full-of-beans/cenmate-fan-controller/hardware/fan-controller.step

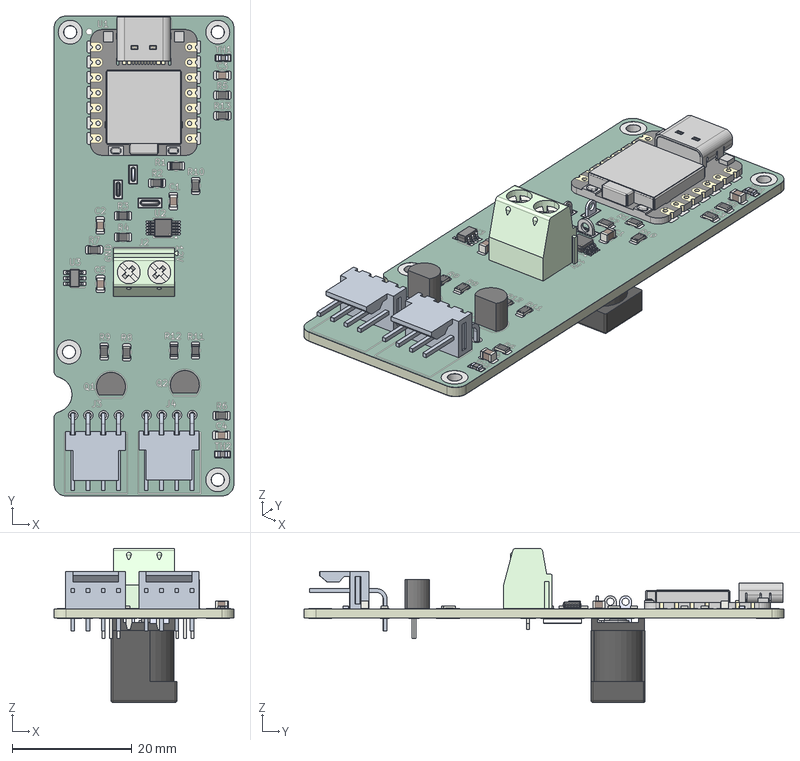
[picture p1: CAD file, 2026-11-06]
hardware/fan-controller.step
30.0 x 80.0 x 25.7 mm
NCU18WB473D60RB x 2
R_0805_2012Metric x 13
C_0805_2012Metric x 5
BODY-SOT
LEAD-SOT x 6
TO-92_Inline_Narrow x 2
XIAO RP2350 v1
BC-508X10-2_GN
TSSOP-10_3x3mm_P0.5mm
CRF2512-FV-R002ELF
fan-controller_copper
fan-controller_pad
fan-controller_via
fan-controller_silkscreen x 2
fan-controller_soldermask x 2
fan-controller_PCB
