full-of-beans/cenmate-fan-controller/hardware/fan-controller.kicad_pcb

## KiCad design hardware/fan-controller.kicad_pcb (2026-11-14)

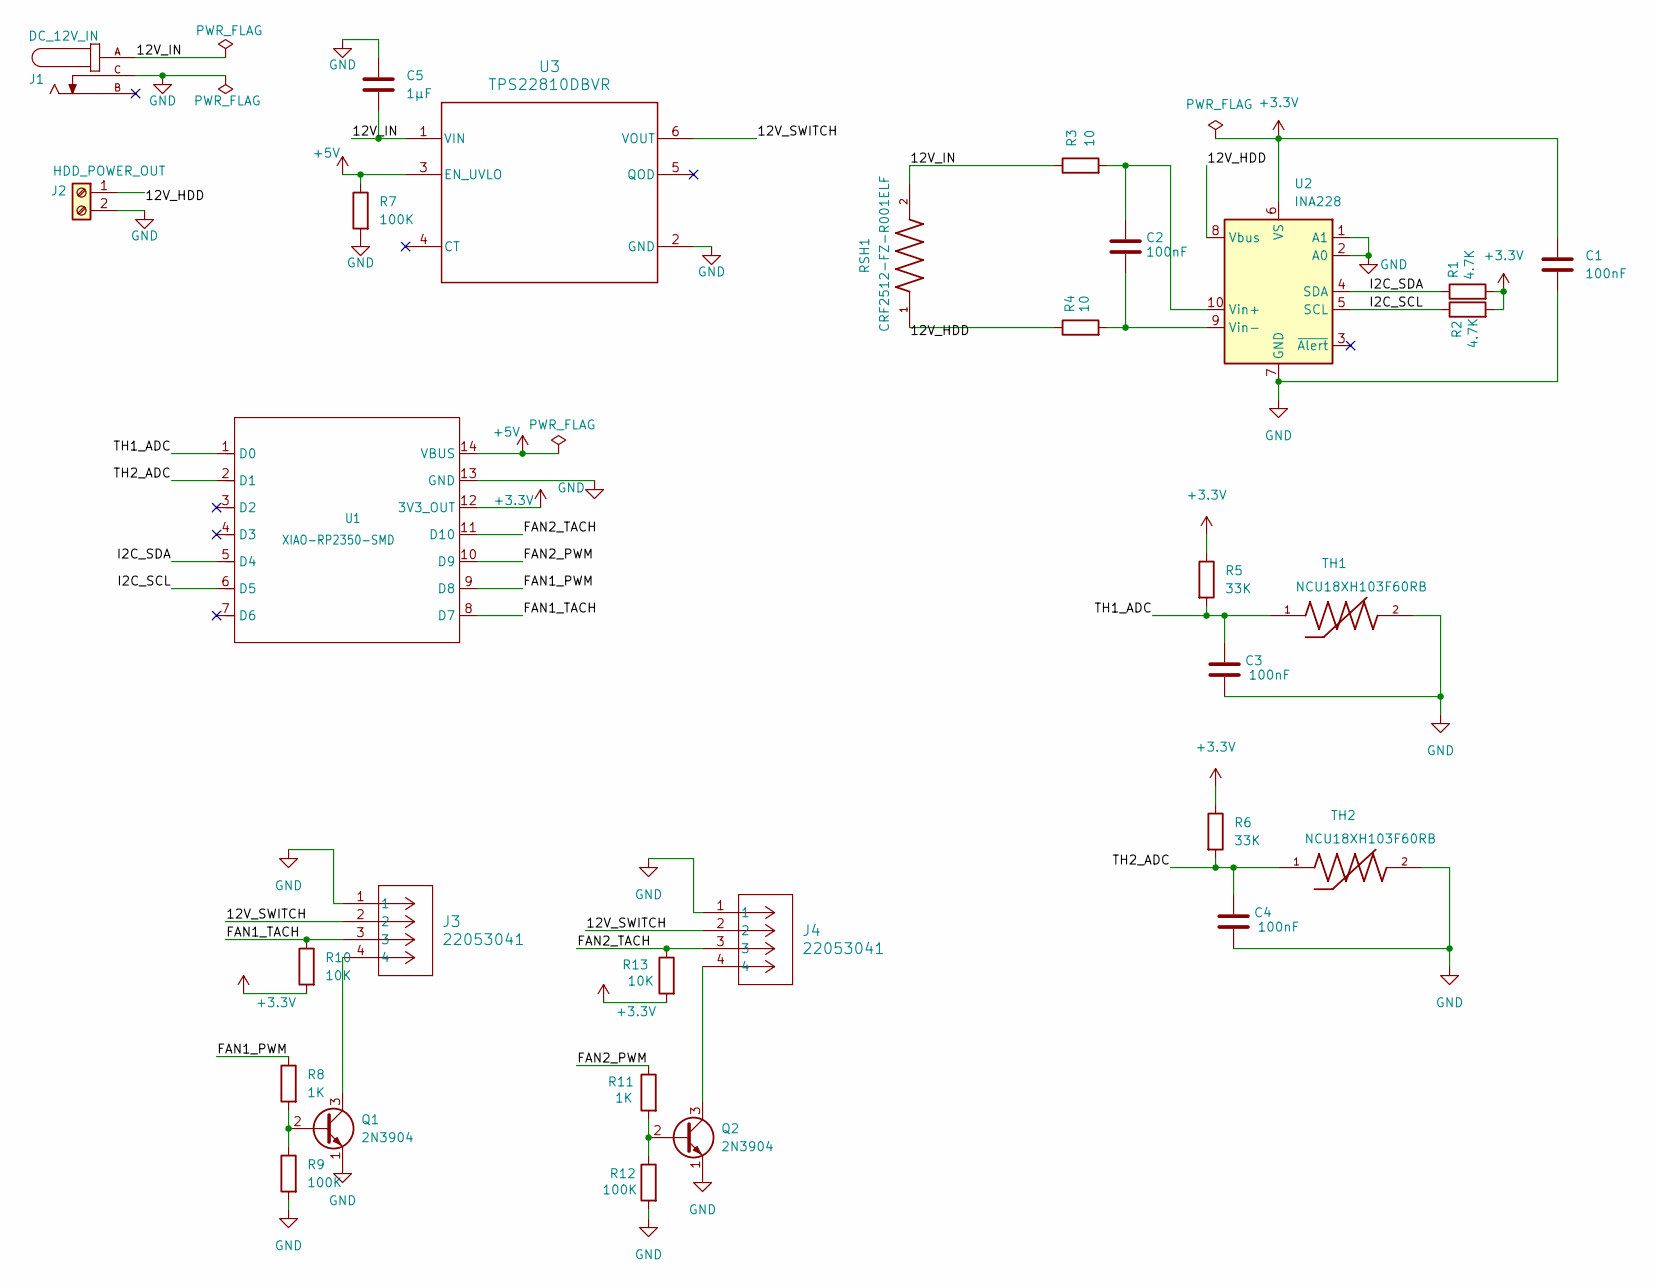
[picture p2: schematic fan-controller.kicad_sch]

Parts:
C1, C2, C3, C4: 100nF; C_0805_2012Metric; MPN CL21B104KACNFNC; DigiKey_PN 1276-2442-1-ND
C5: 1µF; C_0805_2012Metric; MPN GRM219R71E105KA88D; DigiKey_PN 490-5899-1-ND
J1: DC_12V_IN; TENSILITY_54-00286; MPN 54-00286; DigiKey_PN 839-54-00286-ND
J2: HDD_POWER_OUT; PHOENIX_5442206; MPN 5442206; DigiKey_PN 277-12547-ND
J3, J4: 22053041; CONN_A-7478-04A_MOL; MPN 0022053041; DigiKey_PN WM4302-ND
Q1, Q2: 2N3904; TO-92_Inline; MPN 2N3904BU; DigiKey_PN 2N3904FS-ND
R1, R2: 4.7K; R_0805_2012Metric; MPN RC0805FR-074K7L; DigiKey_PN 311-4.70KCRCT-ND
R3, R4: 10; R_0805_2012Metric; MPN RC0805FR-0710RL; DigiKey_PN 311-10.0CRCT-ND
R5, R6: 33K; R_0805_2012Metric; MPN RC0805FR-0733KL; DigiKey_PN 311-33.0KCRCT-ND
R7, R9, R12: 100K; R_0805_2012Metric; MPN RC0805FR-07100KL; DigiKey_PN 311-100KCRCT-ND
R8, R11: 1K; R_0805_2012Metric; MPN RC0805FR-071KL; DigiKey_PN 311-1.00KCRCT-ND
R10, R13: 10K; R_0805_2012Metric; MPN RC0805FR-0710KL; DigiKey_PN 311-10.0KCRCT-ND
RSH1: CRF2512-FZ-R001ELF; RESC6432X80N; MPN CRF2512-FZ-R001ELF; DigiKey_PN CRF2512-FZ-R001ELFCT-ND
TH1, TH2: NCU18XH103F60RB; THRMC1608X95N; MPN NCU18XH103F60RB; DigiKey_PN 490-16279-1-ND
U1: XIAO-RP2350-SMD; XIAO-RP2350-no-underside; MPN 102010550; DigiKey_PN 1597-102010550-ND
U2: INA228; TSSOP-10_3x3mm_P0.5mm; MPN INA228AIDGSR; DigiKey_PN 296-INA228AIDGSRCT-ND
U3: TPS22810DBVR; MPN TPS22810DBVR; DigiKey_PN 296-45297-1-ND

Connections:
+3.3V: C1.1, R1.2, R2.2, R5.1, R6.1, R10.2, R13.2, U1.12 (3V3_OUT), U2.6 (VS)
+5V: R7.1, U1.14 (VBUS), U3.3 (EN_UVLO)
/12V_HDD: J2.1, R4.1, RSH1.1, U2.8 (Vbus)
/12V_IN: C5.2, J1.A, R3.1, RSH1.2, U3.1 (VIN)
/12V_SWITCH: J3.2, J4.2, U3.6 (VOUT)
/FAN1_PWM: R8.1, U1.9 (D8)
/FAN1_TACH: J3.3, R10.1, U1.8 (D7)
/FAN2_PWM: R11.1, U1.10 (D9)
/FAN2_TACH: J4.3, R13.1, U1.11 (D10)
/I2C_SCL: R2.1, U1.6 (D5), U2.5 (SCL)
/I2C_SDA: R1.1, U1.5 (D4), U2.4 (SDA)
/TH1_ADC: C3.1, R5.2, TH1.1, U1.1 (D0)
/TH2_ADC: C4.1, R6.2, TH2.1, U1.2 (D1)
GND: C1.2, C3.2, C4.2, C5.1, J1.C, J2.2, J3.1, J4.1, Q1.1 (E), Q2.1 (E), R7.2, R9.2, R12.2, TH1.2, TH2.2, U1.13 (GND), U2.1 (A1), U2.2 (A0), U2.7 (GND), U3.2 (GND); also elsewhere on the board
unnamed: Q1.2 (B), R8.2, R9.1
unnamed: J3.4, Q1.3 (C)
unnamed: Q2.2 (B), R11.2, R12.1
unnamed: J4.4, Q2.3 (C)
unnamed: C2.1, R3.2, U2.10 (Vin+)
unnamed: C2.2, R4.2, U2.9 (Vin-)

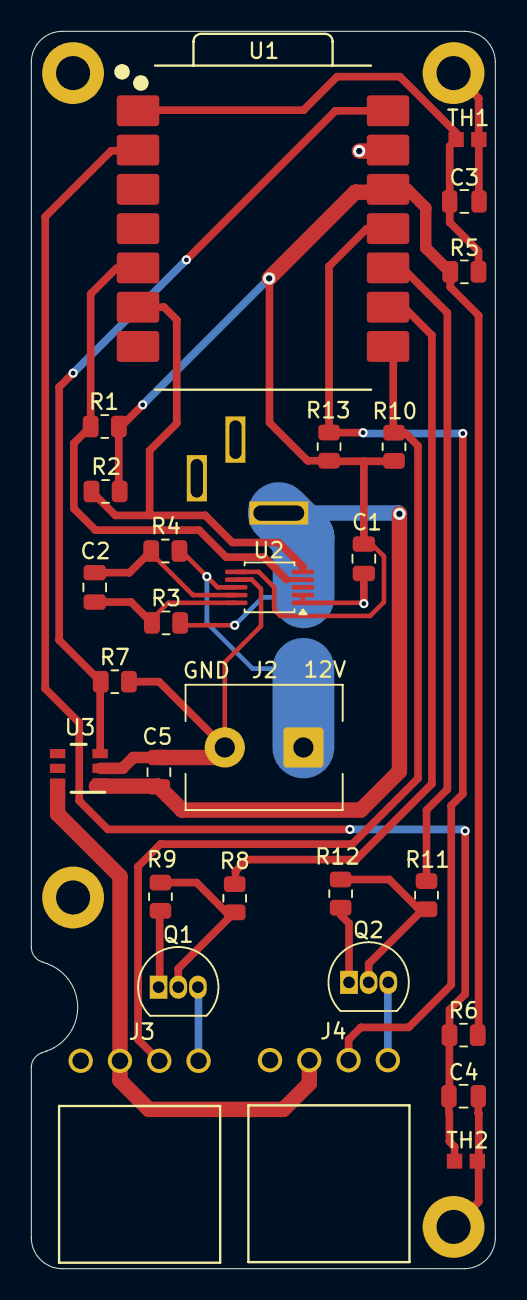
[picture p3: board fan-controller.kicad_pcb from above]

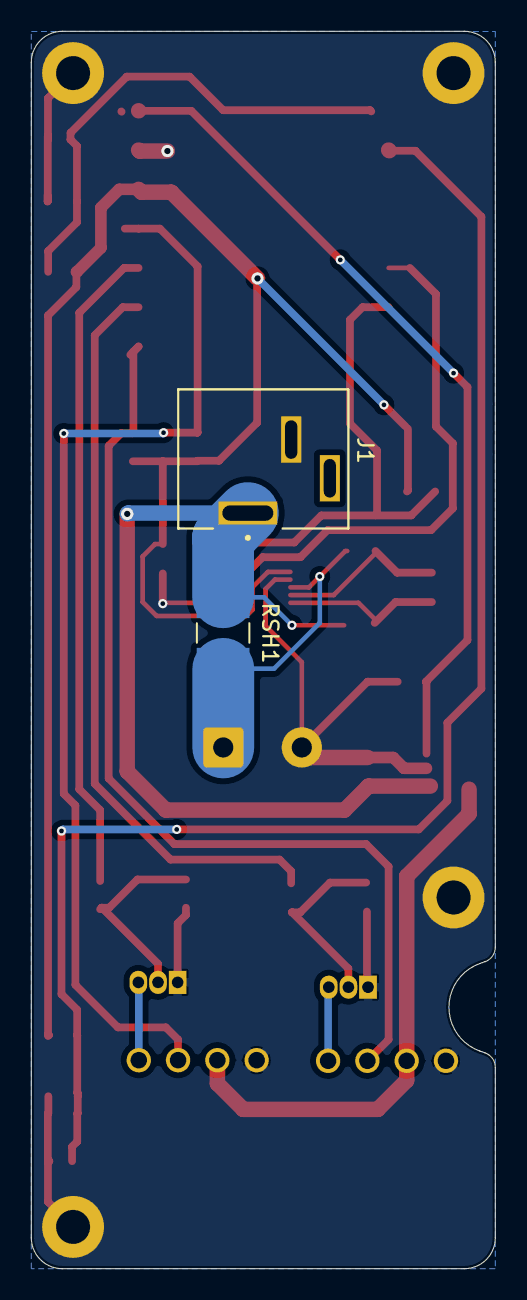
[picture p4: board fan-controller.kicad_pcb from below]

Board: 2 copper layers, 30.0 x 80.0 mm, 34 parts (2 on the bottom side), 20 nets.

Other parts of the board:
H1, H2, H3, H4: MountingHole_2.2mm_M2_Pad_4mm

Their connections:
GND: H1.1, H2.1, H3.1, H4.1; also elsewhere on the board
