full-of-beans/cenmate-fan-controller/(commit log)

2026-10-21 Scaffold hardware/thermistor-strip/.gitkeep
2026-10-21 Initialize KiCad controller and thermistor strip projects
2026-10-30 Restore fan-controller development on main history
2026-10-30 Add Same Sky slide switch to project symbol library
2026-10-30 Add slide switch footprint with project-relative STEP model
2026-10-30 Consolidate Same Sky switch STEP model into project 3dmodels
2026-10-30 Point switch footprint to consolidated 3D model
2026-10-30 Remove redundant Same Sky switch import file
2026-10-30 Track KiCad ERC and DRC reports in Git
2026-10-30 Synchronize custom symbol library definitions with verified schematic symbols
2026-10-30 pcb trace update
2026-10-31 Import Molex 22053041 fan header symbol into project library
2026-10-31 Import right-angle fan header footprint into FanController library
2026-10-31 add fan controller step file
2026-10-31 Attach Molex fan header STEP model to project footprint
2026-10-31 Remove original fan header STEP after relocating into project library
2026-10-31 Add provisional Phoenix 5442206 two-position footprint and STEP reference
2026-10-31 Assign Phoenix 5442206 project footprint to J2 schematic
2026-10-31 Correct Phoenix terminal housing width and depth to manufacturer dimensions
2026-10-31 Match Phoenix 5442206 footprint housing to manufacturer two-position drawing
2026-10-31 add 12V switch for fans
2026-10-31 Add TPS22810DBVR load switch to FanController symbol library
2026-10-31 Add TPS22810DBVR SOT-23-6 footprint and STEP reference
2026-10-31 Link TPS22810DBVR footprint to relocated STEP model
2026-11-02 change pcb dims to 90x32
2026-11-03 adjust annular ring width for Q1/Q2 copper pads and add pull down resistor for 5V switch enable on fan power switch
2026-11-03 Remove unused Same Sky switch symbol from project library
2026-11-03 Document selected DigiKey parts on schematic components
2026-11-03 Add procurement metadata to custom fan-controller symbols
2026-11-03 Complete metadata for Molex fan headers and TPS22810 symbols
2026-11-03 Synchronize datasheet URLs for all fan-controller schematic parts
2026-11-03 update to switch to 30mm wide pcb
2026-11-03 add cutout for m2 standoff post interference
2026-11-03 Lock pcb geometry tied to 3d print backpanel, run ERC for schematic
2026-11-04 add 12V and GND silkscreen to screw terminal footprint
2026-11-04 Repair custom symbol metadata and ERC pin types
2026-11-04 Synchronize ERC pin types and terminal footprint filter
2026-11-04 Fix malformed Datasheet/Description properties and passive fan header pins
2026-11-04 Restrict connector pin-type changes to Molex fan header symbol
2026-11-05 continuous ground plane attempt
2026-11-05 Shift components and re-reoute to accomodate continuous ground plane while avoiding overuse of vias and routes on B side
2026-11-06 recover XIAO RP2350 original footprint
2026-11-06 move point down .5mm for semicircle cut out
2026-11-06 address pcb-001 issue and remove curves in favor of fillets for semi-circle cutout corners
2026-11-06 fix pcb-004
2026-11-06 fix XIAO RP2350 schematic
2026-11-06 address pcb-008
2026-11-06 docs: align README with current fan-controller PCB and prototype risks
2026-11-06 Audit KiCad schematic-to-PCB parity
2026-11-06 add connector
2026-11-06 library: link Amphenol header STEP and normalize footprint pads
2026-11-06 Audit KiCad Gerber and drill manufacturing outputs
2026-11-12 schematic: set INA sense filter R3/R4 to 10 ohm Yageo parts
2026-11-12 move components further from eachother to make hand soldering easier
2026-11-12 Audit November 12 PCB layout and fabrication readiness
2026-11-14 adjust footprint silkscreens to meet min width and add library for P mosfet
2026-11-14 add files to library for 2 pin jst xh right angle
2026-11-14 library: integrate imported JST XH and MOSFET footprints
2026-11-14 replace 12V load switch for fans and run ERC
2026-11-14 library: correct MOSFET and JST pin types and show reference/value
